jmwislez/fli3dv2/kicad/fli3dv2 0.4.0 schematics.pdf

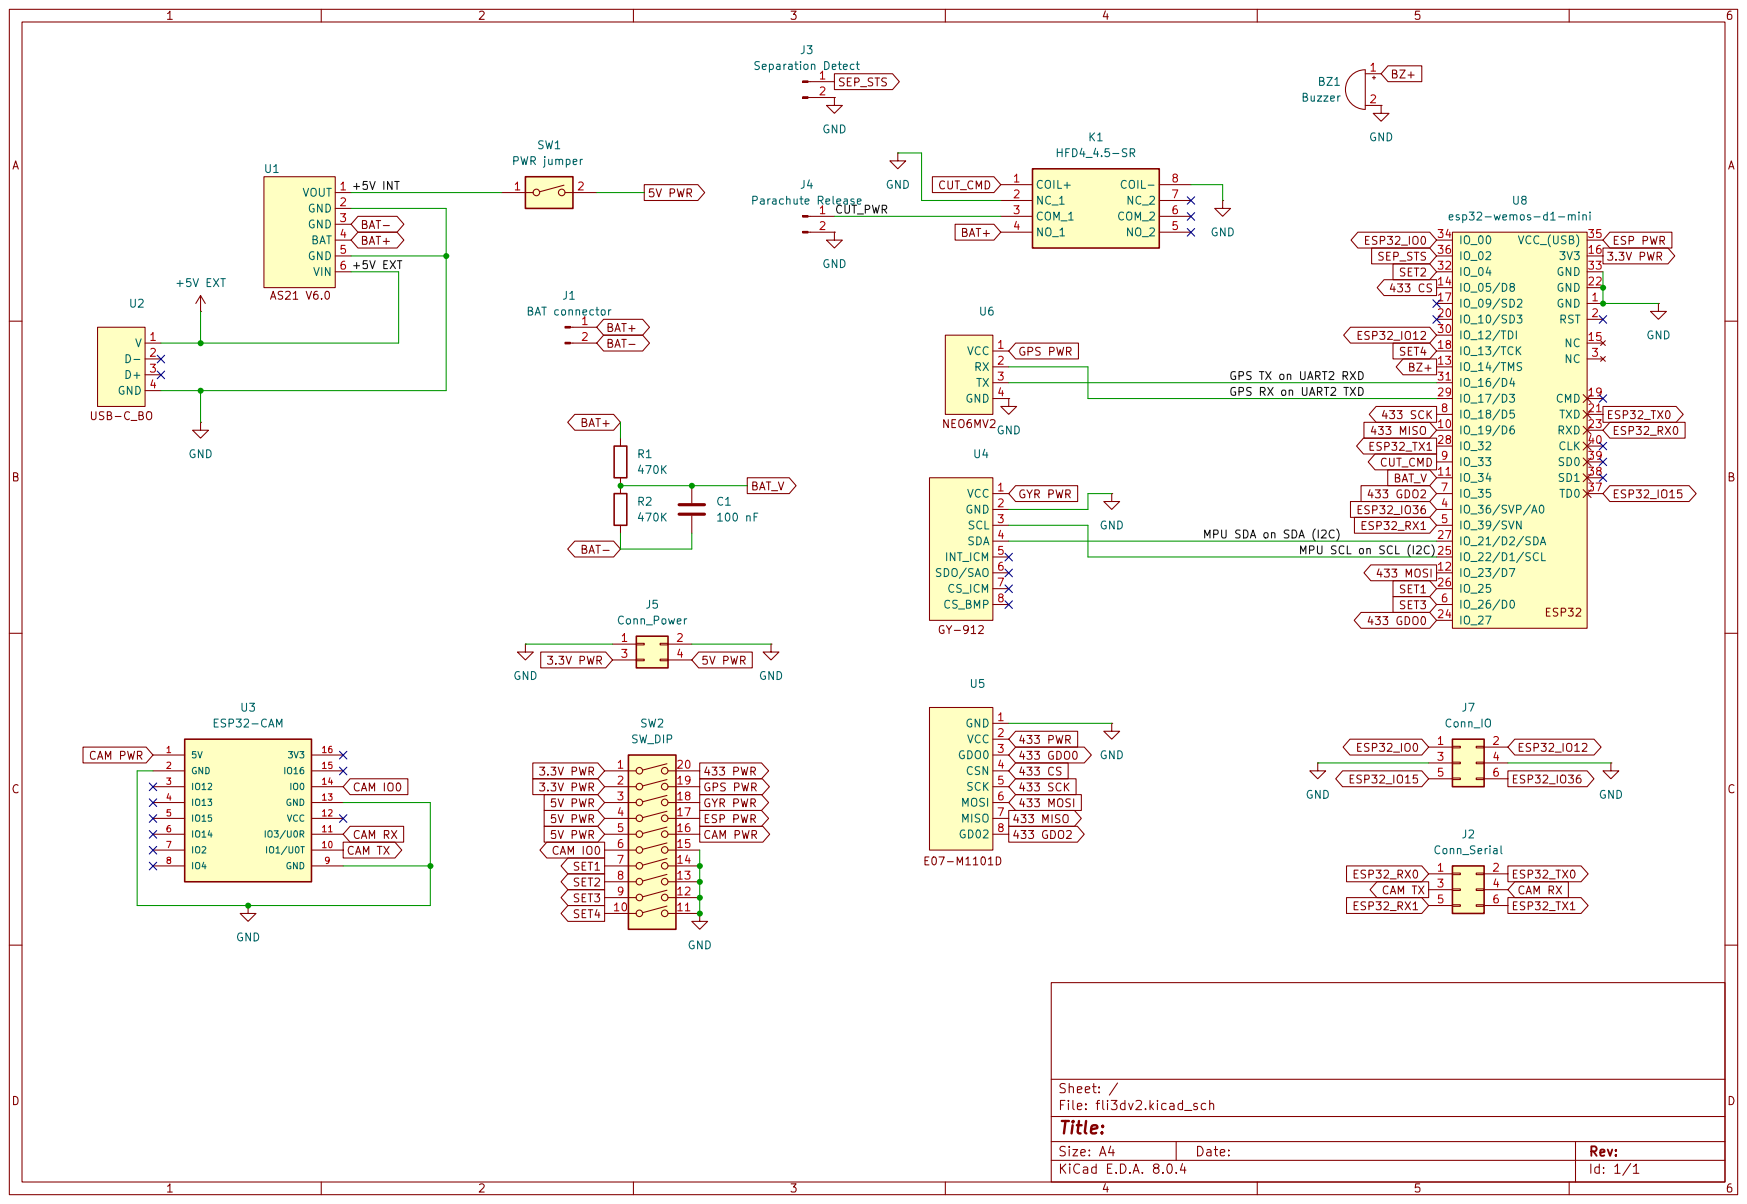
[picture p1: page 1]
