jmwislez/fli3dv2/kicad/fli3dv2 0.4.0 PCB.pdf

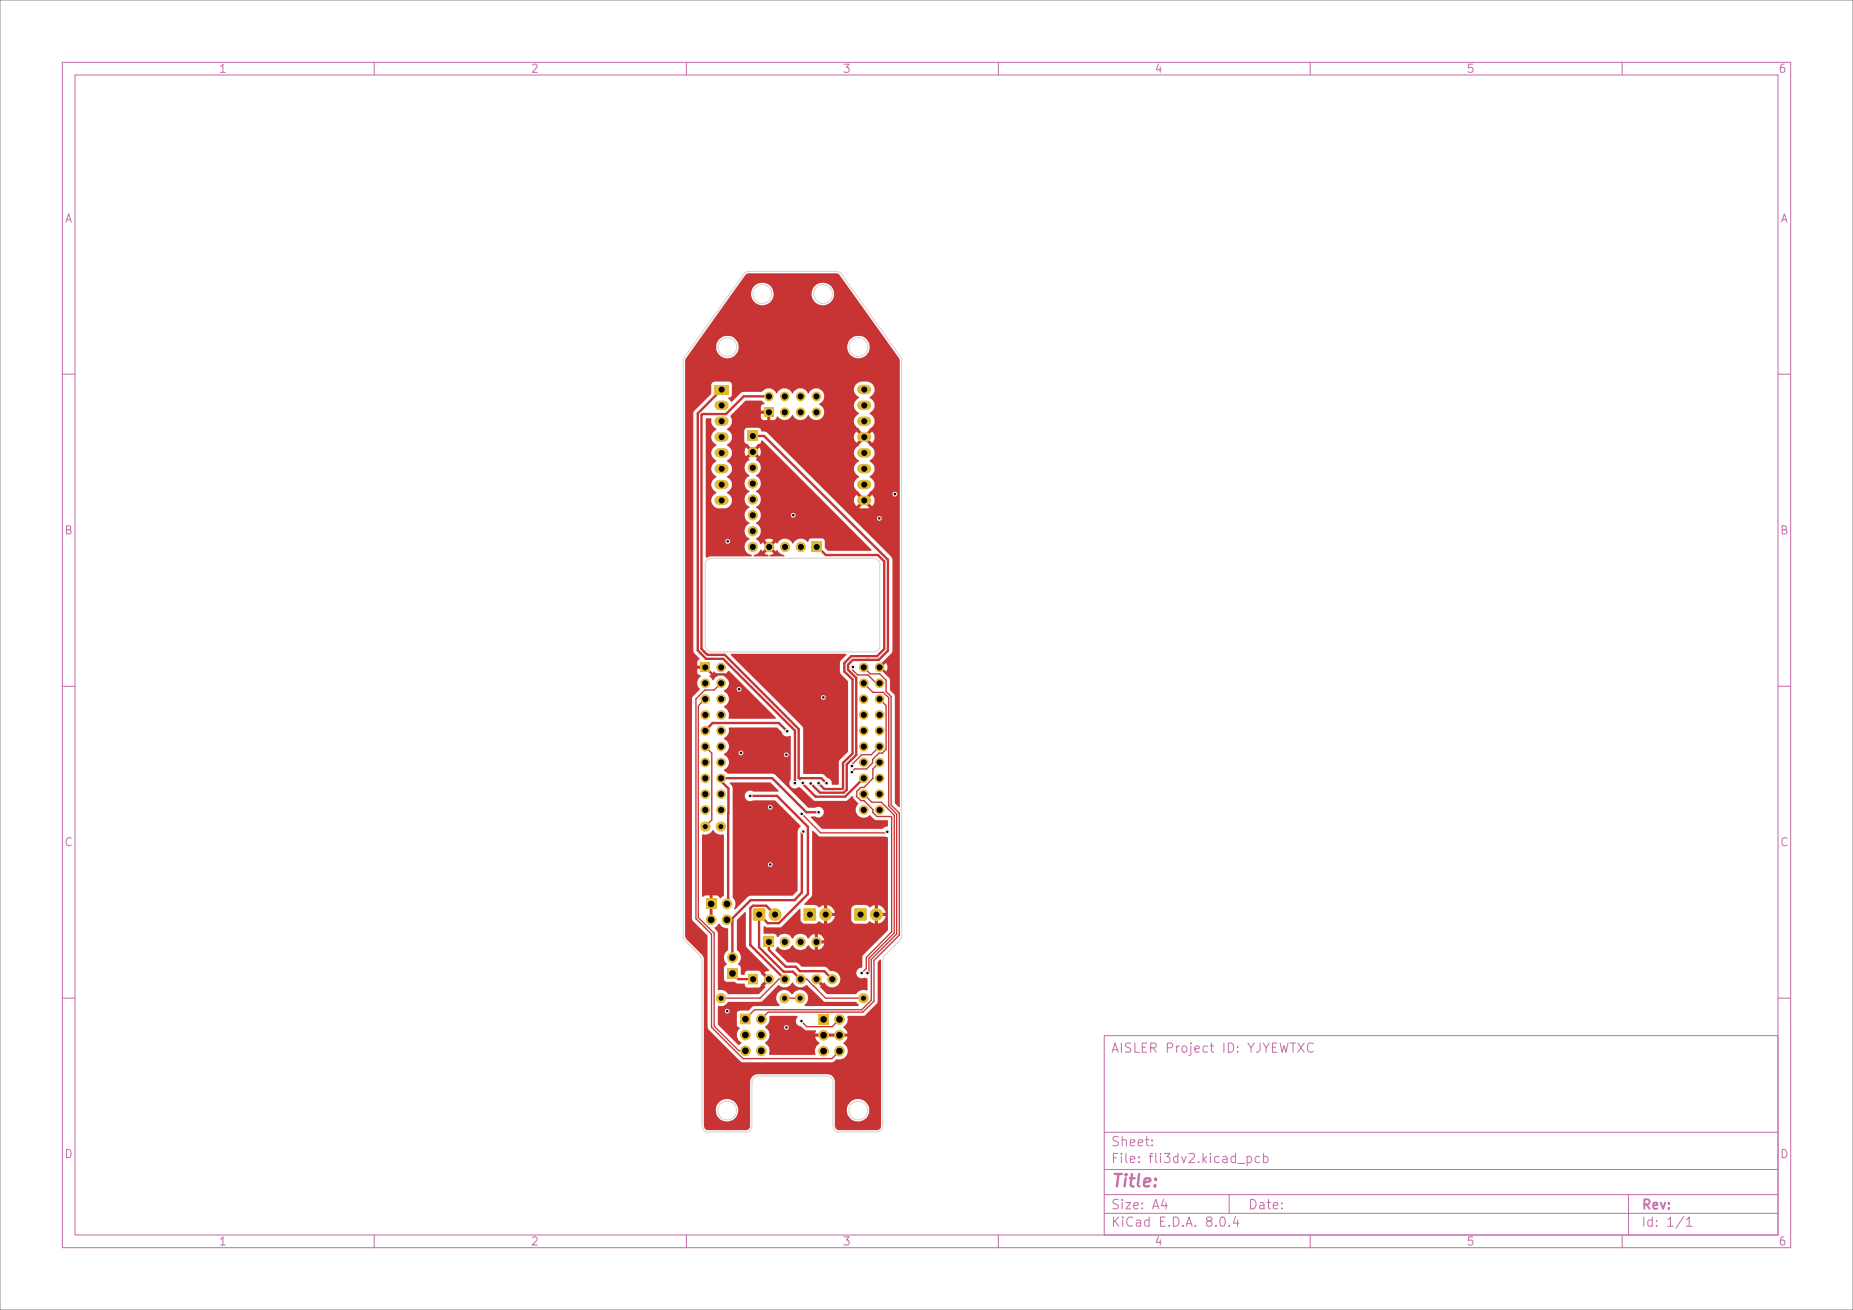
[picture p2: page 1]

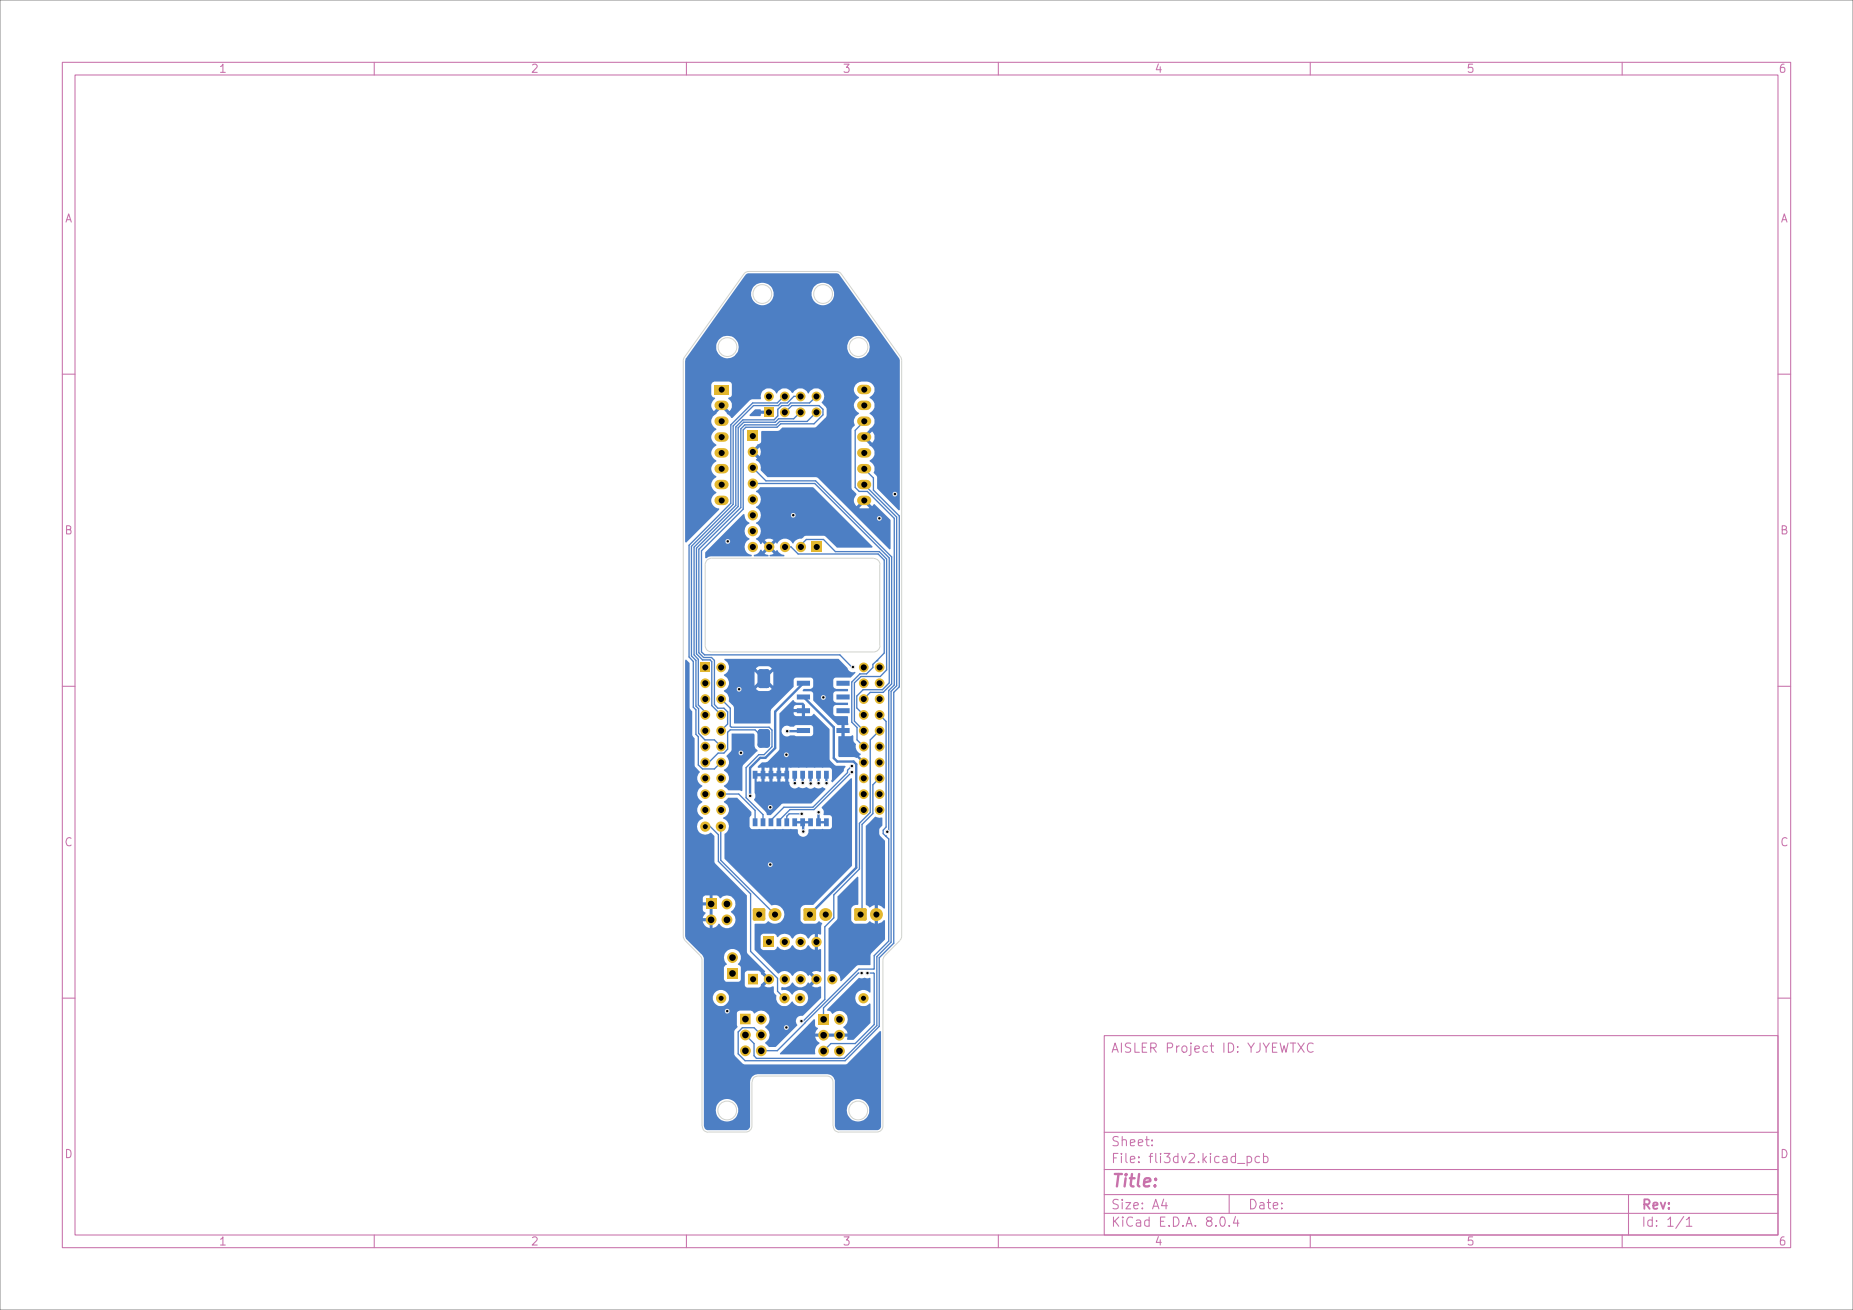
[picture p3: page 2]

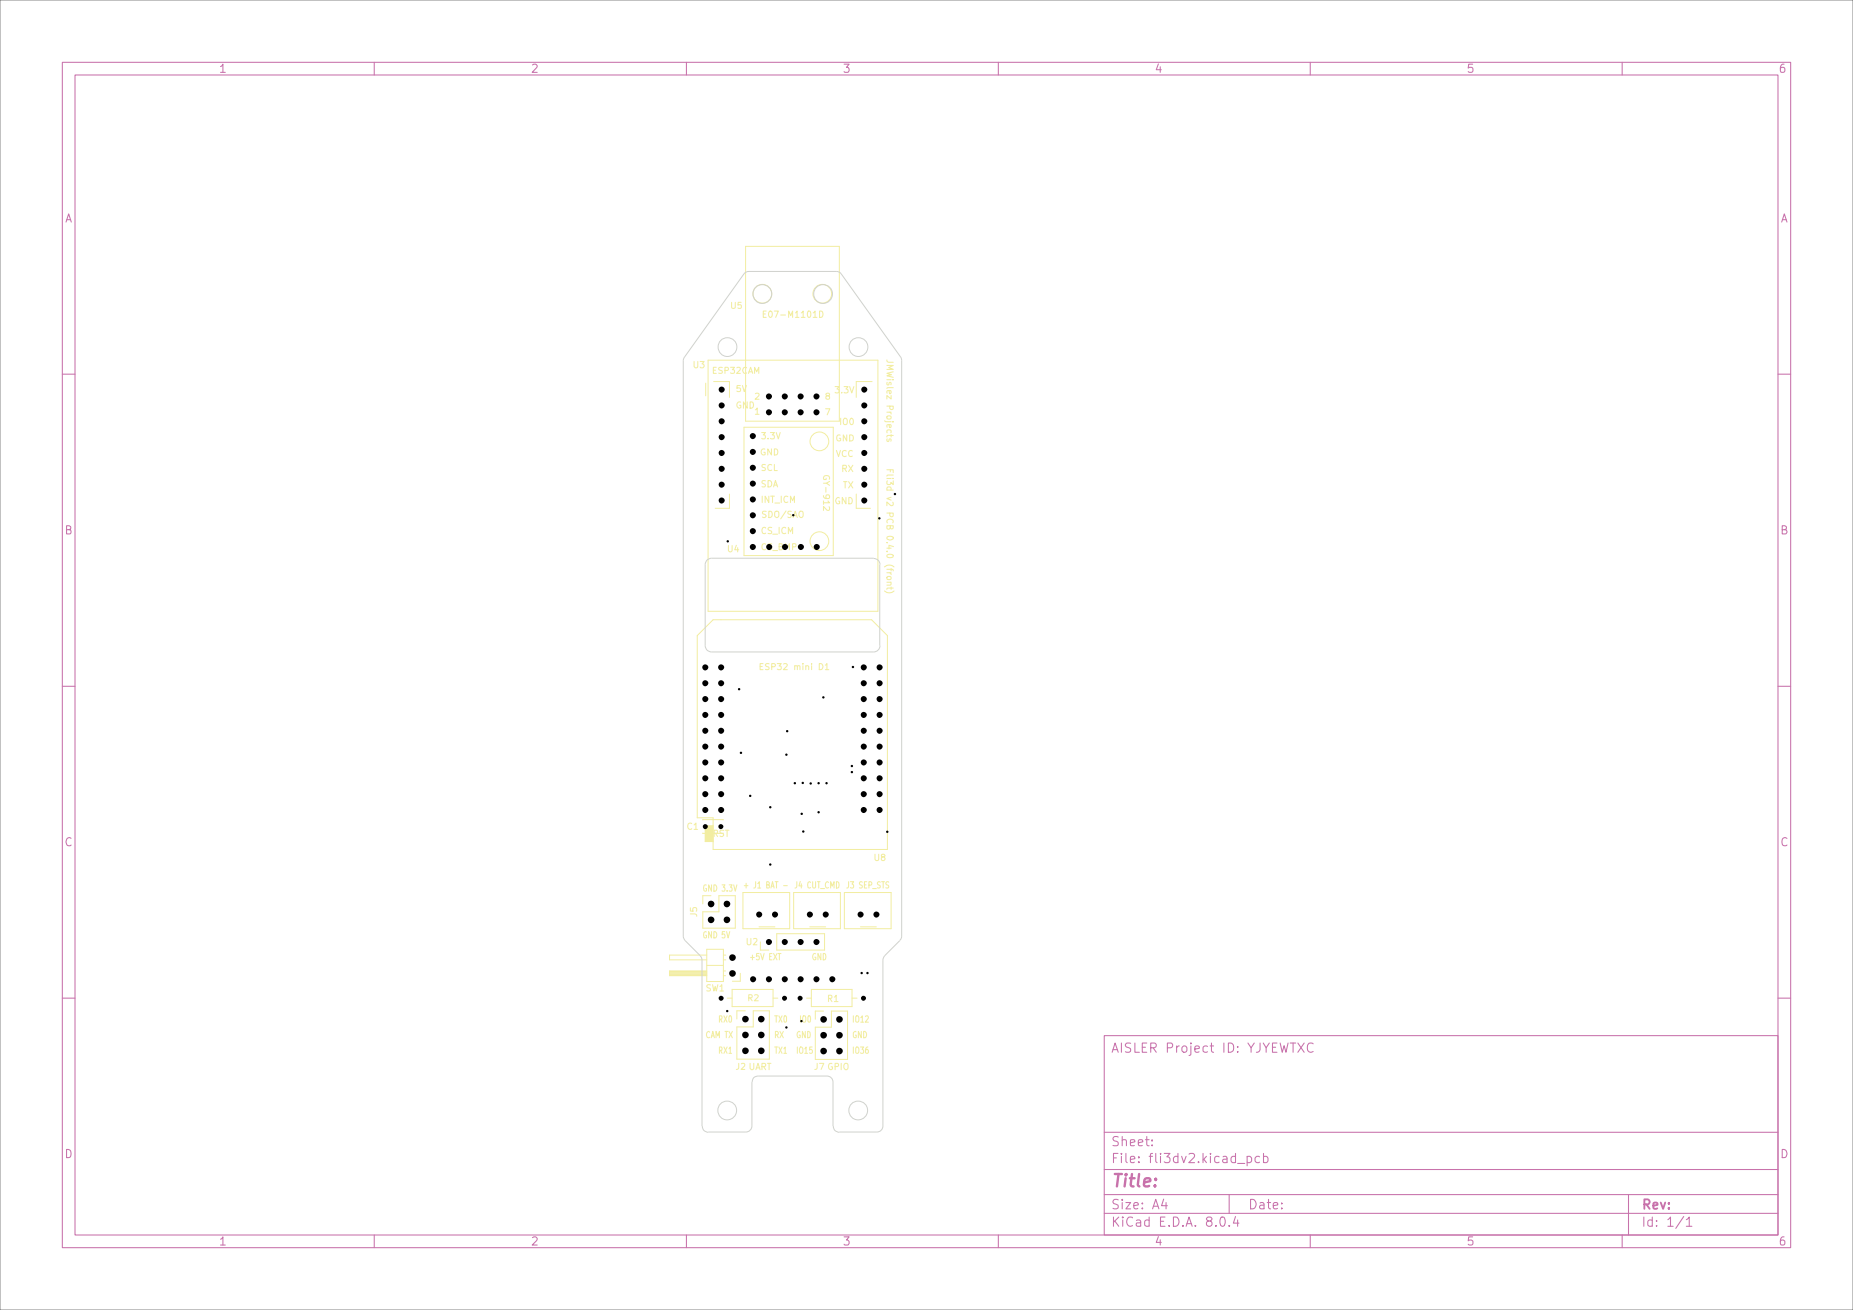
[picture p4: page 3]

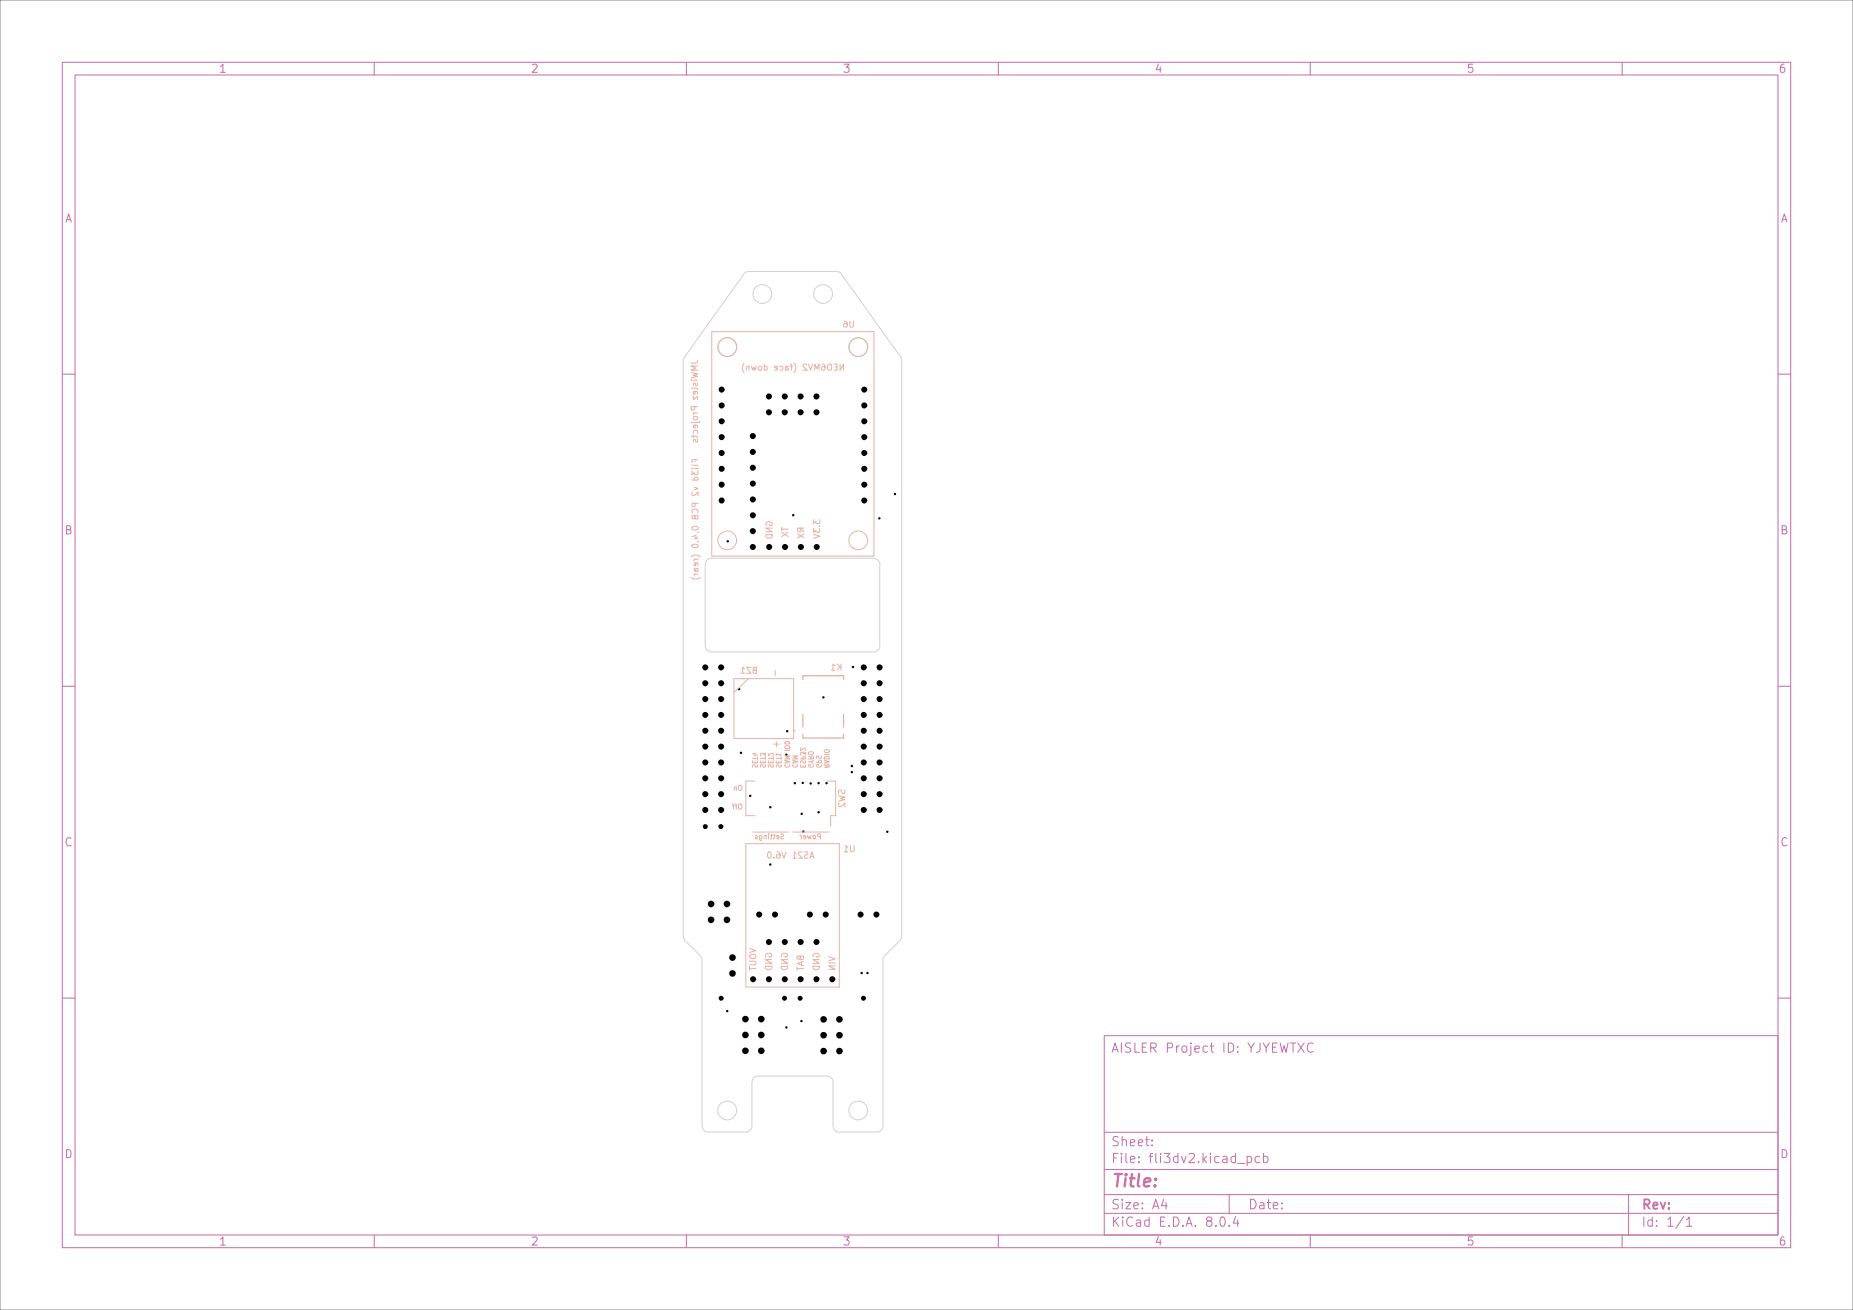
[picture p5: page 4]

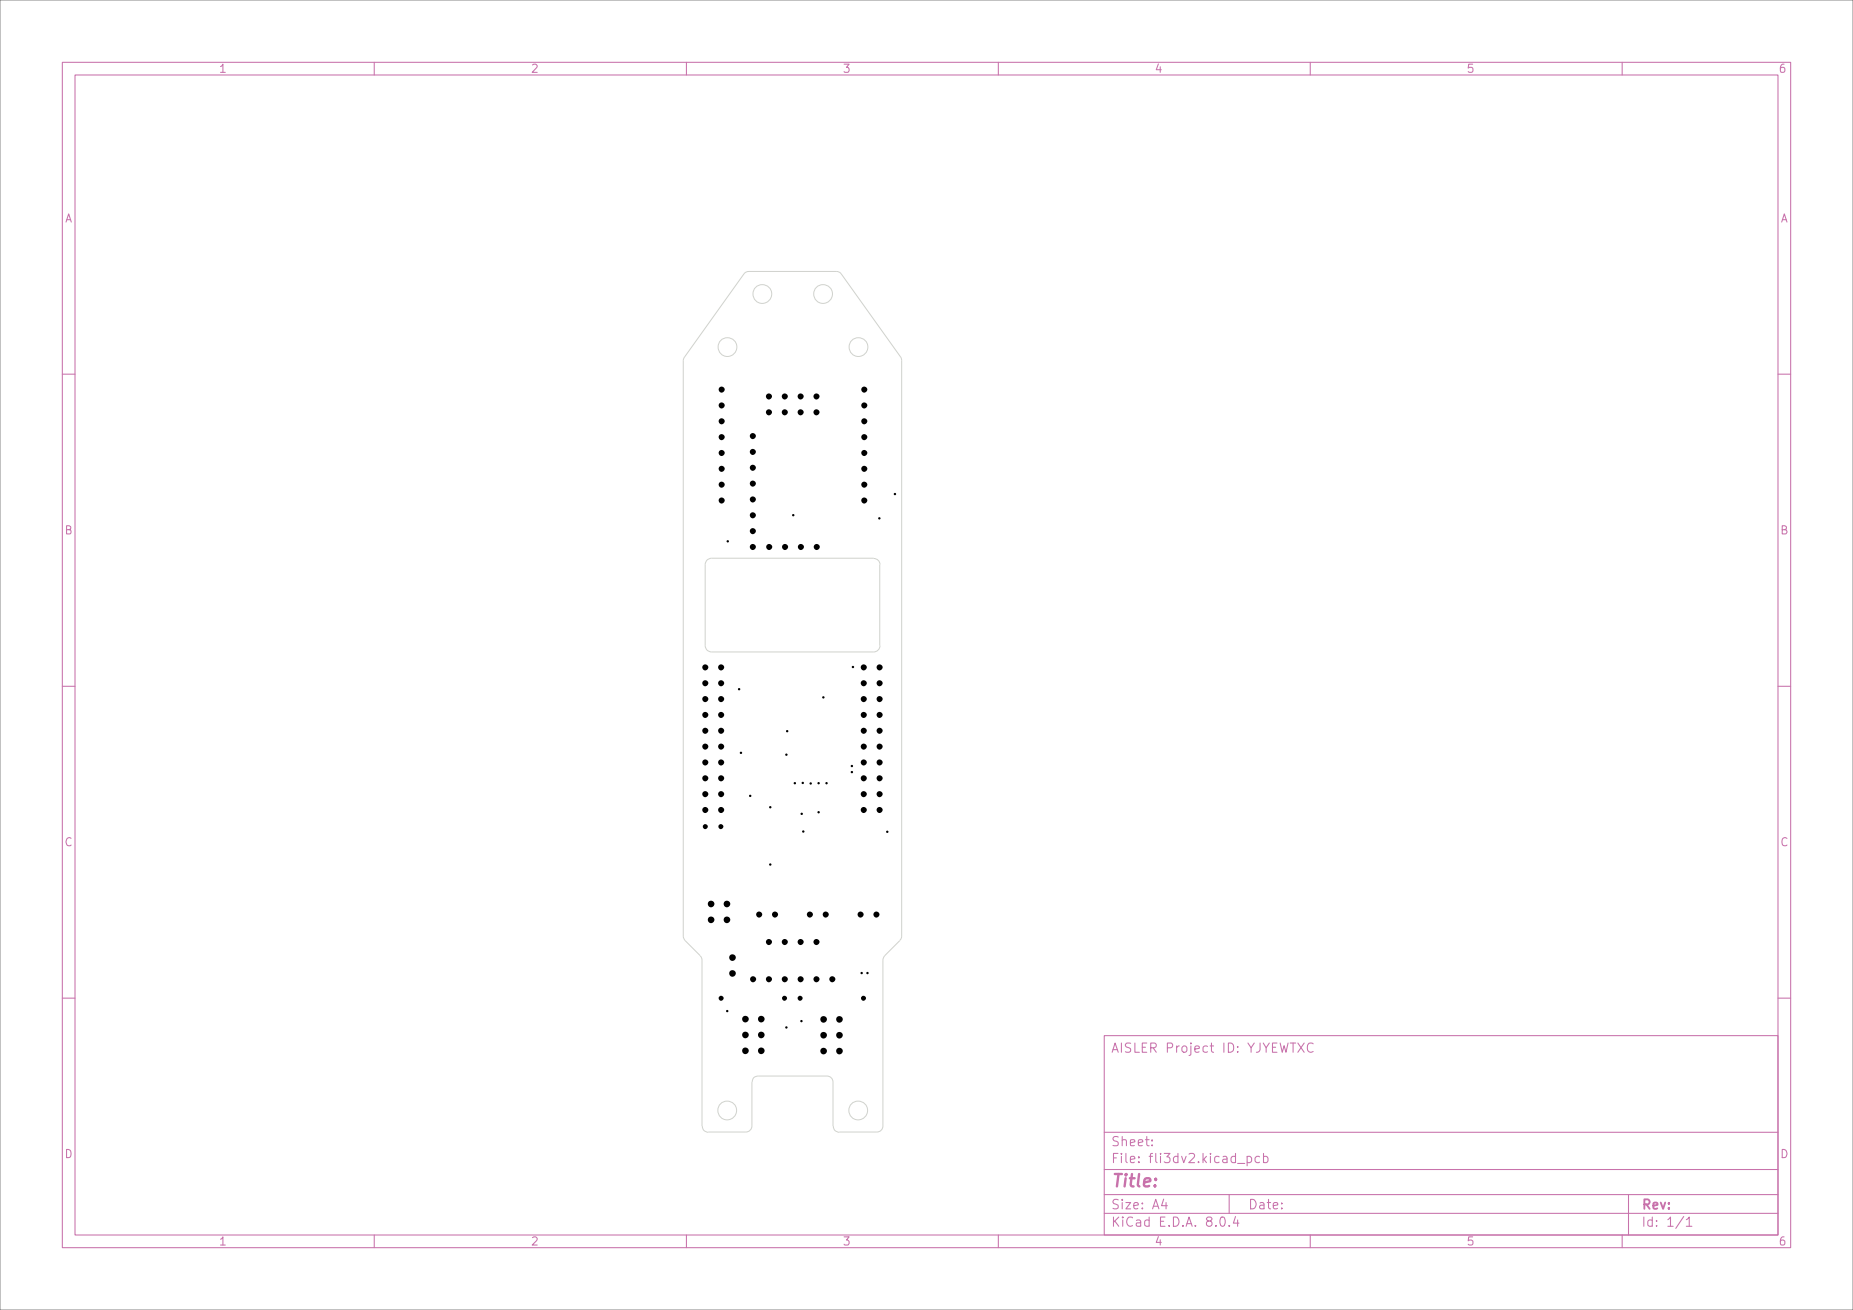
[picture p6: page 5]
