jmwislez/fli3dv2/kicad/fli3dv2.kicad_pcb

## KiCad design kicad/fli3dv2.kicad_pcb (2026-09-13)

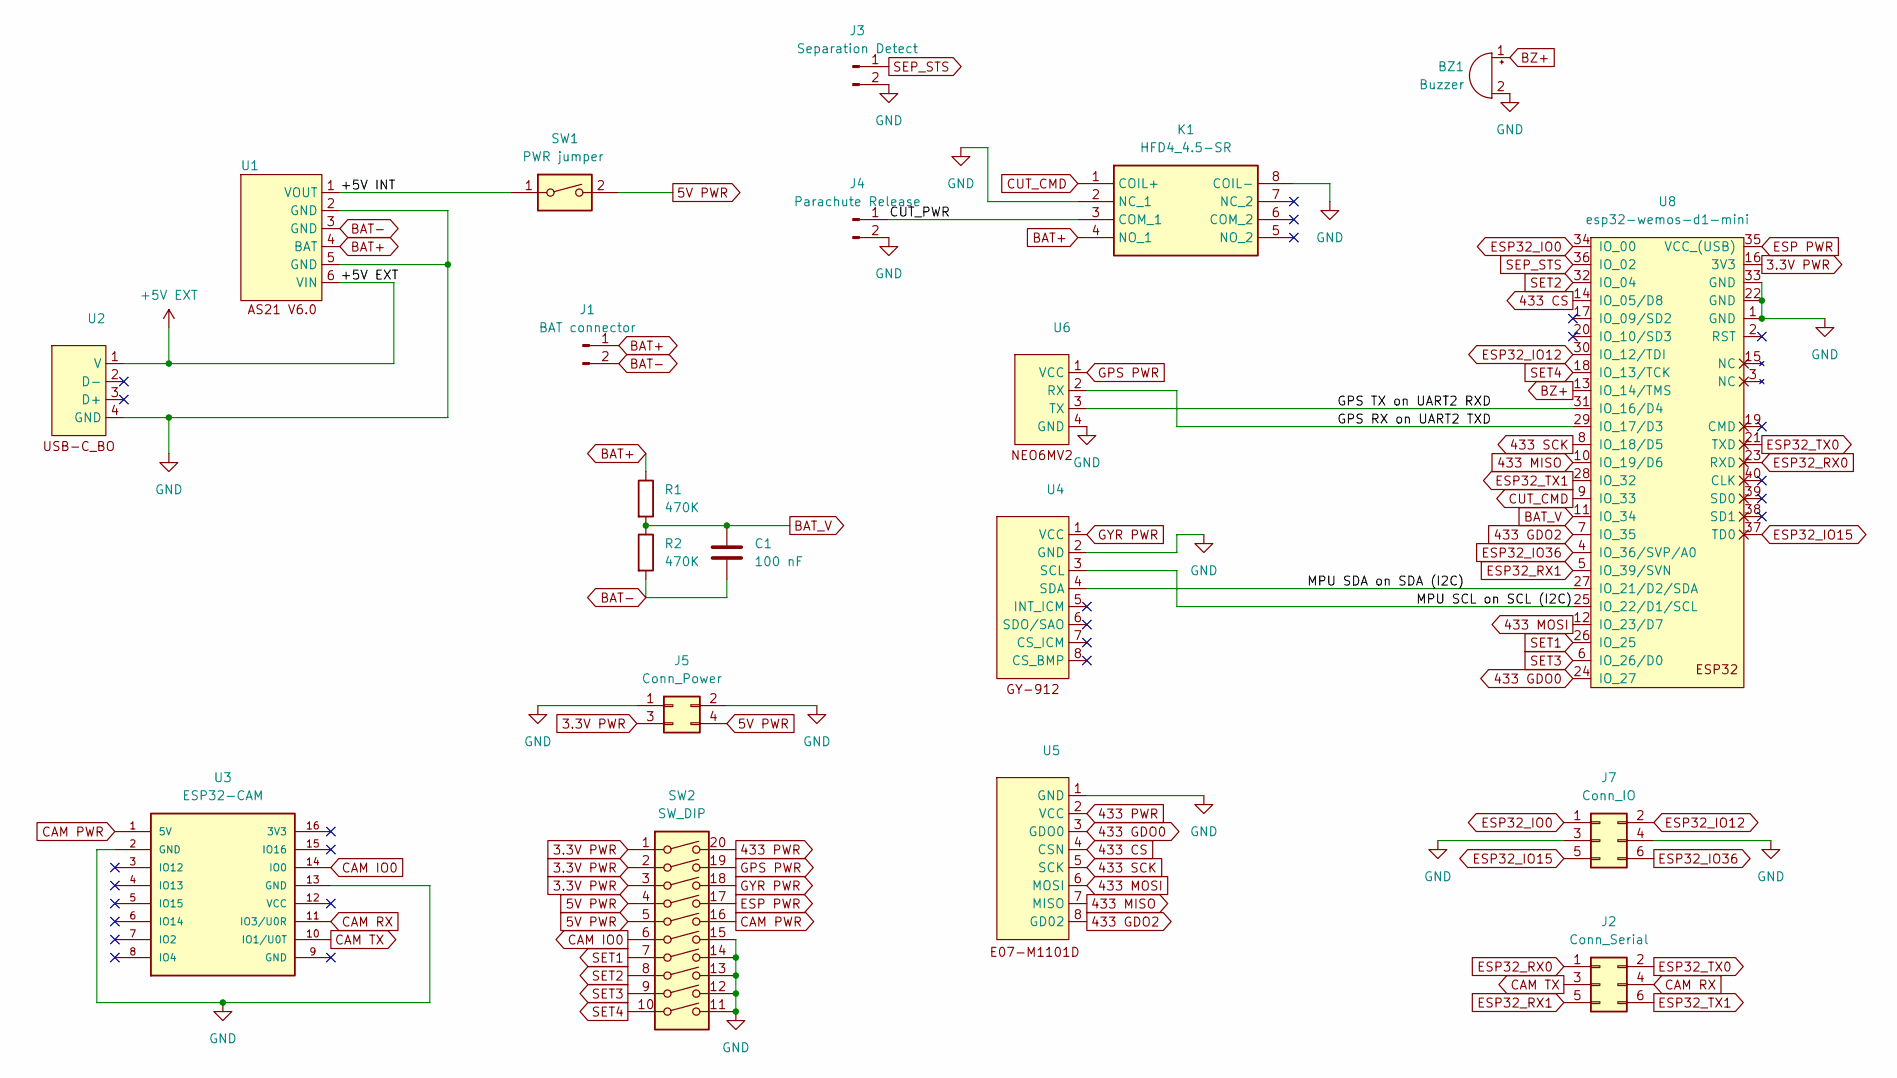
[picture p7: schematic fli3dv2.kicad_sch]

Parts:
BZ1: Buzzer; mini buzzer
C1: 100 nF; C_Disc_D3.0mm_W2.0mm_P2.50mm
J1: BAT connector; XHP_1x02_P2.54mm
J2: Conn_Serial; PinHeader_2x03_P2.54mm_Vertical
J3: Separation Detect; XHP_1x02_P2.54mm
J4: Parachute Release; XHP_1x02_P2.54mm
J5: Conn_Power; PinSocket_2x02_P2.54mm_Vertical
J7: Conn_IO; PinHeader_2x03_P2.54mm_Vertical
K1: HFD4_4.5-SR; HFD445SR; Manufacturer_Part_Number HFD4/4.5-SR
R1, R2: 470K; R_Axial_DIN0207_L6.3mm_D2.5mm_P10.16mm_Horizontal
SW1: PWR jumper; PinHeader_1x02_P2.54mm_Horizontal
SW2: SW_DIP; SW_DIP_SPSTx10_Slide_KingTek_DSHP10TS_W7.62mm_P1.27mm
U1: AS21
U2: USB-C connector
U3: ESP32-CAM; Ai-Thinker_ESP32-CAM
U4: GY-912
U5: E07-M1101D
U6: NEO6MV2 (4 pins)_flipped
U8: esp32-wemos-d1-mini

Connections:
3.3V PWR: J5.3, SW2.1, SW2.2, SW2.3, U8.16 (3V3)
5V PWR: J5.4, SW1.2, SW2.4, SW2.5
433 CS: U5.4 (CSN), U8.14 (IO_05/D8)
433 GDO0: U5.3 (GDO0), U8.24 (IO_27)
433 GDO2: U5.8 (GD02), U8.7 (IO_35)
433 MISO: U5.7 (MISO), U8.10 (IO_19/D6)
433 MOSI: U5.6 (MOSI), U8.12 (IO_23/D7)
433 PWR: SW2.20, U5.2 (VCC)
433 SCK: U5.5 (SCK), U8.8 (IO_18/D5)
+5V EXT: U1.6 (VIN), U2.1 (V)
/+5V INT: SW1.1, U1.1 (VOUT)
/CUT_PWR: J4.1, K1.3 (COM_1)
/GPS RX on UART2 TXD: U6.2 (RX), U8.29 (IO_17/D3)
/GPS TX on UART2 RXD: U6.3 (TX), U8.31 (IO_16/D4)
/MPU SCL on SCL (I2C): U4.3 (SCL), U8.25 (IO_22/D1/SCL)
/MPU SDA on SDA (I2C): U4.4 (SDA), U8.27 (IO_21/D2/SDA)
BAT+: J1.1, K1.4 (NO_1), R1.1, U1.4 (BAT)
BAT-: C1.2, J1.2, R2.2, U1.3 (GND)
BAT_V: C1.1, R1.2, R2.1, U8.11 (IO_34)
BZ+: BZ1.1 (+), U8.13 (IO_14/TMS)
CAM IO0: SW2.6, U3.14 (IO0)
CAM PWR: SW2.16, U3.1 (5V)
CAM RX: J2.4, U3.11 (IO3/U0R)
CAM TX: J2.3, U3.10 (IO1/U0T)
CUT_CMD: K1.1 (COIL+), U8.9 (IO_33)
ESP32_IO0: J7.1, U8.34 (IO_00)
ESP32_IO12: J7.2, U8.30 (IO_12/TDI)
ESP32_IO15: J7.5, U8.37 (TD0)
ESP32_IO36: J7.6, U8.4 (IO_36/SVP/A0)
ESP32_RX0: J2.1, U8.23 (RXD)
ESP32_RX1: J2.5, U8.5 (IO_39/SVN)
ESP32_TX0: J2.2, U8.21 (TXD)
ESP32_TX1: J2.6, U8.28 (IO_32)
ESP PWR: SW2.17, U8.35 (VCC_(USB))
GND: BZ1.2 (-), J3.2, J4.2, J5.1, J5.2, J7.3, J7.4, K1.2 (NC_1), K1.8 (COIL-), SW2.11, SW2.12, SW2.13, SW2.14, SW2.15, U1.2 (GND), U1.5 (GND), U2.4 (GND), U3.2 (GND), U3.13 (GND), U4.2 (GND), U5.1 (GND), U6.4 (GND), U8.1 (GND), U8.22 (GND), U8.33 (GND)
GPS PWR: SW2.19, U6.1 (VCC)
GYR PWR: SW2.18, U4.1 (VCC)
SEP_STS: J3.1, U8.36 (IO_02)
SET1: SW2.7, U8.26 (IO_25)
SET2: SW2.8, U8.32 (IO_04)
SET3: SW2.9, U8.6 (IO_26/D0)
SET4: SW2.10, U8.18 (IO_13/TCK)

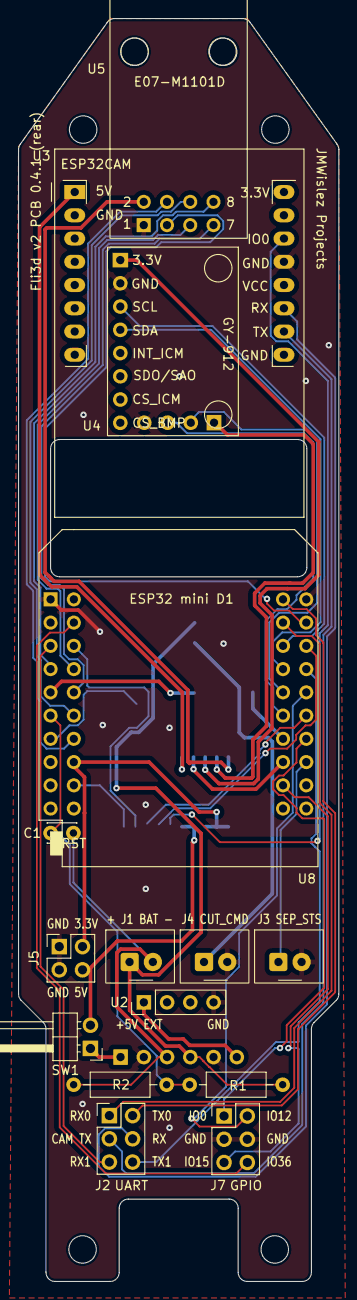
[picture p8: board fli3dv2.kicad_pcb from above]

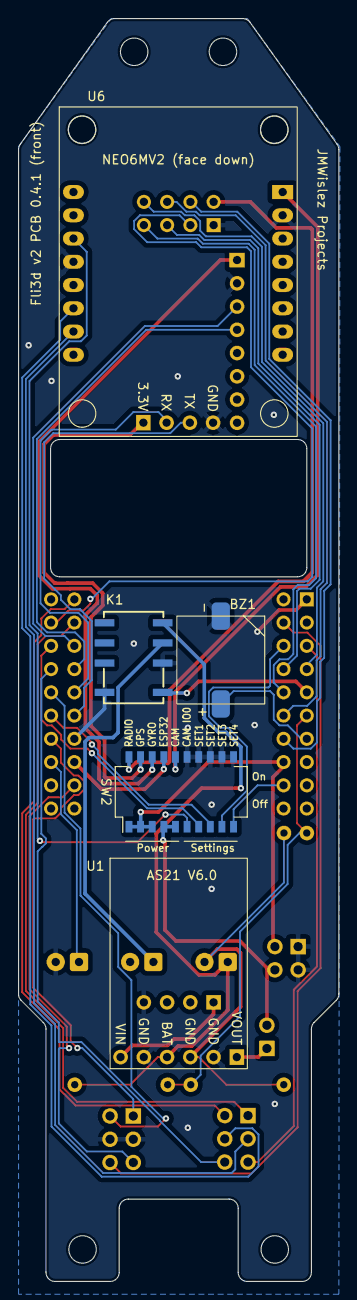
[picture p9: board fli3dv2.kicad_pcb from below]

Board: 2 copper layers, 35.0 x 138.0 mm, 20 parts (5 on the bottom side), 42 nets.
