jmwislez/fli3dv2/yamcs/etc/yamcs.fli3d.yaml

services:
  - class: org.yamcs.archive.XtceTmRecorder
  - class: org.yamcs.archive.ParameterRecorder
  - class: org.yamcs.archive.AlarmRecorder
  - class: org.yamcs.archive.EventRecorder
  - class: org.yamcs.archive.ReplayServer
  - class: org.yamcs.archive.CcsdsTmIndex
  - class: org.yamcs.parameter.SystemParametersService
  - class: org.yamcs.ProcessorCreatorService
    args:
      name: realtime
      type: realtime
  - class: org.yamcs.archive.CommandHistoryRecorder
  - class: org.yamcs.parameterarchive.ParameterArchive
    args:
      realtimeFiller:
        enabled: false
      backFiller:
        enabled: true
        warmupTime: 60

dataLinks:
  - name: gndcrtl-udp-in
    class: org.yamcs.tctm.UdpTmDataLink
    stream: tm_realtime
    port: 10042
    packetPreprocessorClassName: org.yamcs.tctm.GenericPacketPreprocessor
    packetPreprocessorArgs:
      timestampOffset: -1
      seqCountOffset: -1
#    packetPreprocessorClassName: org.yamcs.tctm.cfs.CfsPacketPreprocessor
#    packetPreprocessorArgs:
#      byteOrder: LITTLE_ENDIAN
#      timeEncoding:
#          epoch: CUSTOM
#          epochUTC: "1970-01-01T00:00:00Z"
#          timeIncludesLeapSeconds: false

  - name: sondehub-udp-in
    class: org.yamcs.tctm.UdpTmDataLink
    stream: tm_realtime
    port: 10015
    packetPreprocessorClassName: org.yamcs.tctm.GenericPacketPreprocessor
    packetPreprocessorArgs:
      timestampOffset: -1
      seqCountOffset: -1

  - name: gndctrl-udp-out
    class: org.yamcs.tctm.UdpTcDataLink
    stream: tc_realtime
    host: 127.0.0.1
    port: 10052
    commandPostprocessorClassName: org.yamcs.tctm.IssCommandPostprocessor
      
  - name: tm_file
    class: org.yamcs.tctm.FilePollingTmDataLink
    stream: tm_dump
    incomingDir: files_for_tm_dump
    packetInputStreamClassName: org.yamcs.tctm.CcsdsPacketInputStream
    packetPreprocessorClassName: org.yamcs.tctm.GenericPacketPreprocessor
    packetPreprocessorArgs:
      timestampOffset: -1
      seqCountOffset: -1  
#    packetPreprocessorClassName: org.yamcs.tctm.cfs.CfsPacketPreprocessor
#    packetPreprocessorArgs:
#      byteOrder: LITTLE_ENDIAN
#      timeEncoding:
#          epoch: CUSTOM
#          epochUTC: "1970-01-01T00:00:00Z"
#          timeIncludesLeapSeconds: false
        
mdb:
  # Configuration of the active loaders
  # Valid loaders are: sheet, xtce or fully qualified name of the class
  - type: xtce
    args:
      file: mdb\xtce.fli3d.xml

# Configuration for streams created at server startup
streamConfig:
  tm:
    - name: "tm_realtime"
    - name: "tm_dump"
  cmdHist: ["cmdhist_realtime", "cmdhist_dump"]
  event: ["events_realtime", "events_dump"]
  param: ["pp_realtime", "sys_param", "proc_param"]
  parameterAlarm: ["alarms_realtime"]
  tc: ["tc_realtime"]
