jmwislez/fli3dv2/projects/fli3dv2_esp32/power.cpp

/*
 * Fli3d - power monitoring functionality
 */

#ifdef BATTERY

 #include <Arduino.h>
 #include <fli3dv2.h>
 #include "fli3dv2_esp32.h"
 
void setup_power()
{
  analogSetPinAttenuation(BAT_V_PIN, ADC_11db);
  sprintf (buffer, "Battery monitoring initialized (%lu mV)", 2*analogReadMilliVolts(BAT_V_PIN)); 
  publish_event (STS_THIS, SS_THIS, EVENT_INIT, buffer);
  tm_this->battery_voltage = 2*analogReadMilliVolts(BAT_V_PIN);
}

#endif
