jmwislez/fli3dv2/(commit log)

2026-08-05 Added CAD and PCB design files
    [fli3dv2.kicad_pcb, fli3dv2.kicad_sch]
2026-08-09 Integrated ESP32CAM
2026-08-09 Basic camera streaming functionality
2026-09-02 Baseline for Fli3d Duck development and debugging
    [fli3d_esp32.csv]
2026-09-10 Debugged buffering, NEO6MV2, BMP388 and serial comms to camera
2026-09-11 Debugged archive and gps
    [fli3d_esp32.csv]
2026-09-13 Integrated camera functionality
2026-09-13 PCB v0.4.1: set GY912 on 3.3V and decoupled ESP32CAM GND/R
    [fli3dv2.kicad_pcb, fli3dv2.kicad_sch]
2026-09-24 Completed camera refactoring and implementing RS41
2026-09-26 Version 2.0.0 ready for Fli3d Duck
    [fli3d_esp32_maxfs.csv]
2026-09-26 Minor corrections before flight
    [buzzer.cpp, main.cpp]
